VAleSh-Soft/smartLightSensor/_function.h

#pragma once

#include "header_file.h"
#include "_eeprom.h"

// ===================================================

bool engine_run_flag = false;              // флаг запуска двигателя
WiFiModuleState wifi_state = SLS_WIFI_OFF; // состояние WiFi
uint16_t sensor_data;                      // данные с датчика освещенности

// ===================================================

void checkLightSensor()
{
  if (xSemaphoreTake(xSemaphore_l_sensor, portMAX_DELAY) == pdTRUE)
  {
    sensor_data = (sensor_data * 3 + analogRead(LIGHT_SENSOR_PIN)) / 4;
    if (sensor_data > 4000)
    {
      // чтобы больше 100% не показывало ))
      sensor_data = 4000;
    }
    xSemaphoreGive(xSemaphore_l_sensor);
  }
}

uint16_t getLightSensorData()
{
  uint16_t _data = 0;
  if (xSemaphoreTake(xSemaphore_l_sensor, portMAX_DELAY) == pdTRUE)
  {
    _data = sensor_data;
    xSemaphoreGive(xSemaphore_l_sensor);
  }
  return _data;
}

void setCurrentMode(AutoLightSensorMode _mode)
{
  write_eeprom_8(EEPROM_INDEX_FOR_CURRENT_MODE, uint8_t(_mode));
  SLS_PRINT(F("Setting the current mode: "));
  SLS_PRINTLN(((uint8_t)_mode) ? F("Auto") : F("Manual"));
}

AutoLightSensorMode getCurrentMode()
{
  return (AutoLightSensorMode)read_eeprom_8(EEPROM_INDEX_FOR_CURRENT_MODE);
}

void setEngineRunFlag(bool _flag)
{
  if (xSemaphoreTake(xSemaphore_eng_run, portMAX_DELAY) == pdTRUE)
  {
    engine_run_flag = _flag;
    xSemaphoreGive(xSemaphore_eng_run);
  }
}

bool getEngineRunFlag()
{
  bool _flag = false;
  if (xSemaphoreTake(xSemaphore_eng_run, portMAX_DELAY) == pdTRUE)
  {
    _flag = engine_run_flag;
    xSemaphoreGive(xSemaphore_eng_run);
  }
  return _flag;
}

bool checkEngineRunState()
{
  bool res = false;
  if (xSemaphoreTake(xSemaphore_eng_run, portMAX_DELAY) == pdTRUE)
  {
    res = digitalRead(ENGINE_RUN_PIN);
    xSemaphoreGive(xSemaphore_eng_run);
  }
  return res;
}

void setRelayState(RelayState _rel, bool _state)
{
  if (xSemaphoreTake(xSemaphore_relays, portMAX_DELAY) == pdTRUE)
  {
    if (_rel == SLS_RELAY_PL || _rel == SLS_RELAY_ALL)
    {
      digitalWrite(RELAY_FOR_PL_PIN,
                   (CONTROL_LEVEL_FOR_PL ? (uint8_t)_state : (uint8_t)!_state));
    }
    if (_rel == SLS_RELAY_LB || _rel == SLS_RELAY_ALL)
    {
      digitalWrite(RELAY_FOR_LB_PIN,
                   (CONTROL_LEVEL_FOR_LB ? (uint8_t)_state : (uint8_t)!_state));
    }
#if USE_RELAY_FOR_DRL
#if USE_DRL_MANAGEMENT
    if (_rel == SLS_RELAY_DRL)
    {
      digitalWrite(RELAY_FOR_DRL_PIN,
                   (CONTROL_LEVEL_FOR_DRL ? (uint8_t)_state : (uint8_t)!_state));
    }
    else
    {
      bool x = (digitalRead(RELAY_FOR_PL_PIN) == CONTROL_LEVEL_FOR_PL);
      digitalWrite(RELAY_FOR_DRL_PIN,
                   (CONTROL_LEVEL_FOR_DRL ? (uint8_t)!x : (uint8_t)x));
    }
#else
    if (getEngineRunFlag())
    {
      digitalWrite(RELAY_FOR_DRL_PIN, CONTROL_LEVEL_FOR_DRL);
    }
#endif
#endif
    xSemaphoreGive(xSemaphore_relays);
  }
}

uint8_t getRelayState(RelayState _rel)
{
  uint8_t _state = LOW;
  if (xSemaphoreTake(xSemaphore_relays, portMAX_DELAY) == pdTRUE)
  {
    switch (_rel)
    {
    case SLS_RELAY_LB:
      _state = (digitalRead(RELAY_FOR_LB_PIN) == CONTROL_LEVEL_FOR_LB);
      break;
    case SLS_RELAY_PL:
      _state = (digitalRead(RELAY_FOR_PL_PIN) == CONTROL_LEVEL_FOR_PL);
      break;
#if USE_RELAY_FOR_DRL
    case SLS_RELAY_DRL:
      _state = (digitalRead(RELAY_FOR_DRL_PIN) == CONTROL_LEVEL_FOR_DRL);
      break;
#endif
    default:
      break;
    }
    xSemaphoreGive(xSemaphore_relays);
  }
  return _state;
}

void setWiFiState(WiFiModuleState _state)
{
  if (xSemaphoreTake(xSemaphore_wifi, portMAX_DELAY) == pdTRUE)
  {
    wifi_state = _state;
    xSemaphoreGive(xSemaphore_wifi);
  }
}

WiFiModuleState getWiFiState()
{
  WiFiModuleState _state;
  if (xSemaphoreTake(xSemaphore_wifi, portMAX_DELAY) == pdTRUE)
  {
    _state = wifi_state;
    xSemaphoreGive(xSemaphore_wifi);
  }
  return _state;
}

void startSleep()
{
  // здесь делаем подготовку ко сну
  vTaskSuspend(xTask_leds);
  fastLedShow(CRGB::Black);
  pinMode(RELAY_FOR_LB_PIN, INPUT);
  pinMode(RELAY_FOR_PL_PIN, INPUT);
#if USE_RELAY_FOR_DRL
  pinMode(RELAY_FOR_DRL_PIN, INPUT);
#endif

  if (getWiFiState() != SLS_WIFI_OFF)
  {
    wifiStop();
    setWiFiState(SLS_WIFI_OFF);
  }

  SLS_PRINTLN(F("Switching to sleep mode"));
  SLS_PRINTLN();
  esp_deep_sleep_enable_gpio_wakeup(1 << IGNITION_PIN, ESP_GPIO_WAKEUP_GPIO_HIGH);
  esp_deep_sleep_start();
}

void wifiStop()
{
  HTTP.stop();
  WiFi.softAPdisconnect(true);
  WiFi.mode(WIFI_OFF);
  SLS_PRINTLN(F("Access point stop"));
}

bool getIgnitionState()
{
  bool _state = false;
  if (xSemaphoreTake(xSemaphore_ign_flag, portMAX_DELAY) == pdTRUE)
  {
    _state = digitalRead(IGNITION_PIN);
    xSemaphoreGive(xSemaphore_ign_flag);
  }
  return _state;
}

inline String getApSsid()
{
  return read_string_from_eeprom(EEPROM_INDEX_FOR_AP_SSID, MAX_AP_SSID_LENGHT);
}

inline String getApPassword()
{
  return read_string_from_eeprom(EEPROM_INDEX_FOR_AP_PASSWORD, MAX_AP_PASSWORD_LENGHT);
}

void fastLedShow(CRGB _col)
{
  if (xSemaphoreTake(xSemaphore_fastled, portMAX_DELAY) == pdTRUE)
  {
    leds[0] = _col;
    FastLED.setBrightness(ledBrightness);
    FastLED.show();
    xSemaphoreGive(xSemaphore_fastled);
  }
}

void setLedBrightness(uint8_t _br)
{
  if (xSemaphoreTake(xSemaphore_fastled, portMAX_DELAY) == pdTRUE)
  {
    uint8_t level = read_eeprom_8(EEPROM_INDEX_FOR_LED_BRIGHTNESS_LEVEL);
    if (level == 0 || level > 10)
    {
      level = (level > 10) ? 10 : 1;
      write_eeprom_8(EEPROM_INDEX_FOR_LED_BRIGHTNESS_LEVEL, level);
    }

    ledBrightness = uint8_t((uint16_t)_br * level / 10);
    xSemaphoreGive(xSemaphore_fastled);
  }
}

void wifiModuleManagement()
{
  static uint32_t slsDelay = 100ul;

  switch (getWiFiState())
  {
  case SLS_WIFI_CONNECT:
    WiFi.mode(WIFI_AP);
    WiFi.softAPConfig(IPAddress(read_eeprom_32(EEPROM_INDEX_FOR_AP_IP)),
                      IPAddress(read_eeprom_32(EEPROM_INDEX_FOR_AP_IP)),
                      IPAddress(255, 255, 255, 0));
    if (WiFi.softAP(getApSsid().c_str(), getApPassword().c_str()))
    {
#if LOG_ON
      SLS_PRINTLN(F("Access point start"));
      printWiFiSetting();
      SLS_PRINTLN();
#endif
      slsDelay = 1ul; // в режиме точки доступа крутим быстро для нормальной реакции сервера
      HTTP.begin();
      setWiFiState(SLS_WIFI_AP);
    }
    break;
  case SLS_WIFI_OFF:
    if (WiFi.getMode() != WIFI_OFF)
    {
      wifiStop();
      slsDelay = 100ul; // если точка доступа отключена, замедляемся
    }
    break;
  case SLS_WIFI_AP:
    HTTP.handleClient();
    break;
  }

  delay(slsDelay);
}

#if LOG_ON
void printCurrentSettings()
{
  SLS_PRINTLN(F("================================="));
  SLS_PRINTLN(F("Current settings:"));
  SLS_PRINTLN();
  SLS_PRINT(F("  Current mode: "));
  SLS_PRINTLN(((uint8_t)getCurrentMode()) ? F("Auto") : F("Manual"));
  SLS_PRINT(F("  Liht sensor threshold: "));
  SLS_PRINT(read_eeprom_16(EEPROM_INDEX_FOR_LIGHT_SENSOR_THRESHOLD) / 40);
  SLS_PRINTLN(F(" %"));
  SLS_PRINT(F("  Low beam shutdown delay (seconds): "));
  SLS_PRINTLN(read_eeprom_8(EEPROM_INDEX_FOR_LB_SHUTDOWN_DELAY));
  SLS_PRINT(F("  Delay for turn ON (seconds): "));
  SLS_PRINTLN(read_eeprom_8(EEPROM_INDEX_FOR_TURN_ON_DELAY));
  SLS_PRINT(F("  Delay for starting sleep mode (seconds): "));
  SLS_PRINTLN(read_eeprom_8(EEPROM_INDEX_FOR_STARTING_SLEEP_DELAY));
  SLS_PRINTLN();
  SLS_PRINTLN(F("Settings for AP:"));
  SLS_PRINTLN();
  printWiFiSetting();
  SLS_PRINTLN(F("================================="));
  SLS_PRINTLN();
}
void printWiFiSetting()
{
  SLS_PRINT(F("  AP SSID: "));
  SLS_PRINTLN(getApSsid());
  SLS_PRINT(F("  AP password: "));
  SLS_PRINTLN(getApPassword());
  SLS_PRINT(F("  AP IP: "));
  SLS_PRINTLN(IPAddress(read_eeprom_32(EEPROM_INDEX_FOR_AP_IP)).toString());
}
#endif

// ===================================================

class slsButton : public shButton
{
private:
public:
  slsButton(byte button_pin) : shButton(button_pin)
  {
    shButton::setVirtualClickOn(true);
    shButton::setLongClickMode(LCM_ONLYONCE);
    shButton::setTimeoutOfLongClick(1000);
  }
};

slsButton btnMode(BTN_MODE_PIN); // кнопка выбора режима работы

// ===================================================
