VAleSh-Soft/smartLightSensor/(commit log)

2025-07-29 update schematic
2025-08-26 fix schematic
